Wu-Wu/flood-guard/SPECIFICATION.md

Спецификация оборудования
=========================

Наименование                                         | Кол-во | Артикул                  | Примечания
---------------------------------------------------- | ------ | ------------------------ | ------------------------------------------------------
Контроллер CCU825-PLC/D/AE-P h/w 16.00, f/w 02.22    | 1      | CCU825-PLC/D/AE-P        | [CCU825 DIN](https://radsel.ru/products/ccu825.html)
Аккумуляторная батарея CSB GP 1272                   | 1      | n/a                      |
Шаровый электропривод Gidrolock Ultimate Bugatti 12V | 2      | [GIDROLOCK ULTIMATE](http://gidrolock.ru/uploads/pages/page4/Pasport_GIDROLOCK_ULTIMATE_.pdf) | Dy = 1/2"
Проводной датчик протечки воды Gidrolock WSP         | 2      | n/a                      | [датчики протечки](http://gidrolock.ru/production/datchiki-protechki-vody-gidrolock/)
Проводной датчик протечки воды Gidrolock WSU         | 2      | n/a                      | [датчики протечки](http://gidrolock.ru/production/datchiki-protechki-vody-gidrolock/)
Выключатель ABB E211-16-20                           | 2     | [2CCA703005R0001](http://new.abb.com/products/2CCA703005R0001) |
Выключатель ABB E213-16-001                          | 2     | [2CCA703040R0001](http://new.abb.com/products/2CCA703040R0001) |
Реле промежуточное ABB CR-P012DC2                    | 1     | [1SVR405601R4000](http://new.abb.com/products/1SVR405601R4000) |
Цоколь стандартный ABB CR-PSS                        | 1     | [1SVR405650R1000](http://new.abb.com/products/1SVR405650R1000) |
Лампа индикаторная ABB E219-E (жёлтый)               | 1     | [2CCA703403R0001](http://new.abb.com/products/2CCA703403R0001) |
Лампа индикаторная ABB E219-C48 (красный)            | 1     | [2CCA703421R0001](http://new.abb.com/products/2CCA703421R0001) |
Лампа индикаторная ABB E219-D48 (зелёный)            | 2     | [2CCA703422R0001](http://new.abb.com/products/2CCA703422R0001) |
Лампа индикаторная ABB E219-E48 (жёлтый)             | 1     | [2CCA703423R0001](http://new.abb.com/products/2CCA703423R0001) |
Лампа индикаторная ABB E219-G48 (синий)              | 1     | [2CCA703424R0001](http://new.abb.com/products/2CCA703424R0001) |
Клемма винтовая ABB MA2.5/5 (серый)                  | 6     | [1SNA115486R0300](http://new.abb.com/products/1SNA115486R0300) |
Клемма винтовая ABB MA2.5/5.N (синий)                | 5     | [1SNA125486R0500](http://new.abb.com/products/1SNA125486R0500) |
Клемма винтовая ABB MA2.5/5.P (жёлто-зелёный)        | 2     | [1SNA165488R2700](http://new.abb.com/products/1SNA165488R2700) |
Ограничитель на DIN рейку (металл) IEK               | 5     | [YXD10](http://iek.ru/products/catalog/detail.php?ID=9239) |
Панель монтажная NT с DIN-рейкой 19", 3U чёрный      | 1     | [127793](http://www.nttelecom.ru/shop/products/product/nt-panel-assembly-3u-b-panel-montazhnaya-19-s-din-/) |
Кабель Netrix inwire UTP 4PR 24AWG cat.5e            | 10    | 201-0010 | метров
Кабель ВВГ-нг-LS 4х1.5                               | 10    | n/a | метров
Провод ПуГВ 1х0.75 (красный)                         | 3     | n/a | метров
Провод ПуГВ 1х0.75 (белый)                           | 2     | n/a | метров
Провод ПуГВ 1х0.75 (синий)                           | 2     | n/a | метров
Провод ПуГВ 1х0.75 (чёрный)                          | 3     | n/a | метров
Клемма ножевая F1-6.4V                               | 2     | n/a |
Наконечник штыревой изолированный НШВИ 0.75-8        | 42    | n/a |
Наконечник штыревой изолированный НШВИ(2) 0.75-8     | 15    | n/a |
Трубка термоусадочная 2.4/1.2 (жёлтый)               | 0.3   | n/a | метра
Трубка термоусадочная 2.4/1.2 (зелёный)              | 0.3   | n/a | метра
Трубка термоусадочная 3.2/1.6 (жёлто-зелёный)        | 0.05  | n/a | метра
Трубка термоусадочная 3.2/1.6 (красный)              | 0.1   | n/a | метра
Трубка термоусадочная 3.2/1.6 (синий)                | 0.1   | n/a | метра
Трубка термоусадочная 6.4/3.2 (зелёный)              | 0.1   | n/a | метра
Трубка термоусадочная 6.4/3.2 (чёрный)               | 0.1   | n/a | метра
Расширяющийся витой PET рукав 3 мм (оранжевый)       | 0.6   | n/a | метра
Расширяющийся витой PET рукав 4 мм (оранжевый)       | 1     | n/a | метра
Кабель питания 230V Euro, 3x0.75, 1.8 м              | 1     | n/a |
