Wu-Wu/flood-guard/(list of files, drawings)

Other design files:
schemes/indicator_unit.dch
