Wu-Wu/flood-guard/(commit log)

2016-05-13 grace timer to open valves on dry
2016-05-13 добавлено описание: сценарии
2016-05-13 плашка лицензии
2016-05-13 проводим техобслуживание без ухода в режим наблюдение
2016-05-13 описание функции
2016-05-13 время техобслуживания приводов кранов
2016-05-13 сброс режима отсрочки
2016-05-13 сбрасываем уведомления о внешнем питании в период тишины
2016-05-13 обработка оставшихся системных событий
2016-05-14 некоторые фиксы документации
2016-05-14 добавлен смыл буквенных идентификаторов
2016-05-14 ещё немного фиксов сценариев
2016-05-14 спецификация оборудования
2016-05-14 фиксы спецификации
2016-05-14 фиксы спецификации+
2016-05-14 немного возможностей в доку
2016-05-14 период отсрочки в именованной константе
2016-05-14 унификация имён программ мигания индикаторами
2016-05-14 фиксы имён
2016-05-14 док: ручной режим управления
2016-05-14 фикс моделей датчиков
2016-05-17 фиксы спецификации материалов
2016-05-17 минор
2016-05-18 фикс описания выхода кранов
2016-05-19 реинициализация режима охраны до периода отсрочки
2016-05-30 добавлена схема индикатора
    [indicator_unit.dch]
2016-05-30 мелкий фикс описания
2016-05-30 мелкий фикс описания+
2021-01-03 переименование сценариев
2021-01-03 добавляем сценарии групп 4..8
2021-01-03 фикс описания картинки
2021-01-03 переименовывам служебные сценарии
2021-01-03 функция вычисления сценария для входа
2021-01-03 выдаём сценарий на индикатор тревоги в зависимости от номера входа
2021-01-03 небольшие улучшения кода. избавляемся от магических чисел
2021-01-03 рефакторинг проверки других входов на активность
2021-01-03 форматирование кода блока обработки событий
2021-01-03 вызов функций с передачей номера входа. добавлена обработка дополнительных входов
2021-01-03 константы более не требуются
2021-01-03 фикс номеров в служебных сценариях
2021-01-03 рефакторинг поиска любого активного датчика
2021-01-03 константы идентификаторов датчиков более не требуются
2021-01-03 меняем день и время техобслуживания
2021-01-03 меняем день и время техобслуживания+
2021-01-03 избавляемся от лишних констант периодов
2021-01-03 описания констант
2021-01-03 избавляемся от FLASH_OFF
2021-01-03 форматирование кода
2021-01-03 фикс имени переменной техобслуживания кранов
2021-01-03 фикс модели контроллера в спецификации
2021-01-03 фикс модели контроллера в спецификации+
2021-01-03 гасим все индикаторы при инициализации
2021-01-03 не выходим за границы допустимого диапазона входов
2021-01-03 фиксы использования входов/датчиков
2021-01-10 выделяем диапазон для датчиков
2021-01-10 добавляем проверку входа перед обработкой его события
2021-01-10 фиксы определения границ в разных местах
2021-01-10 переименование константы максимального количества датчиков
2021-01-10 дока по конфигурации количества входов
2021-01-10 документация: сценарий 9
2021-01-10 документация: фиксы alt морзе
